marcorispoli/PCB313/Modelli/Scheda3D/M-RJE03-188-0X10-REVT1.STEP

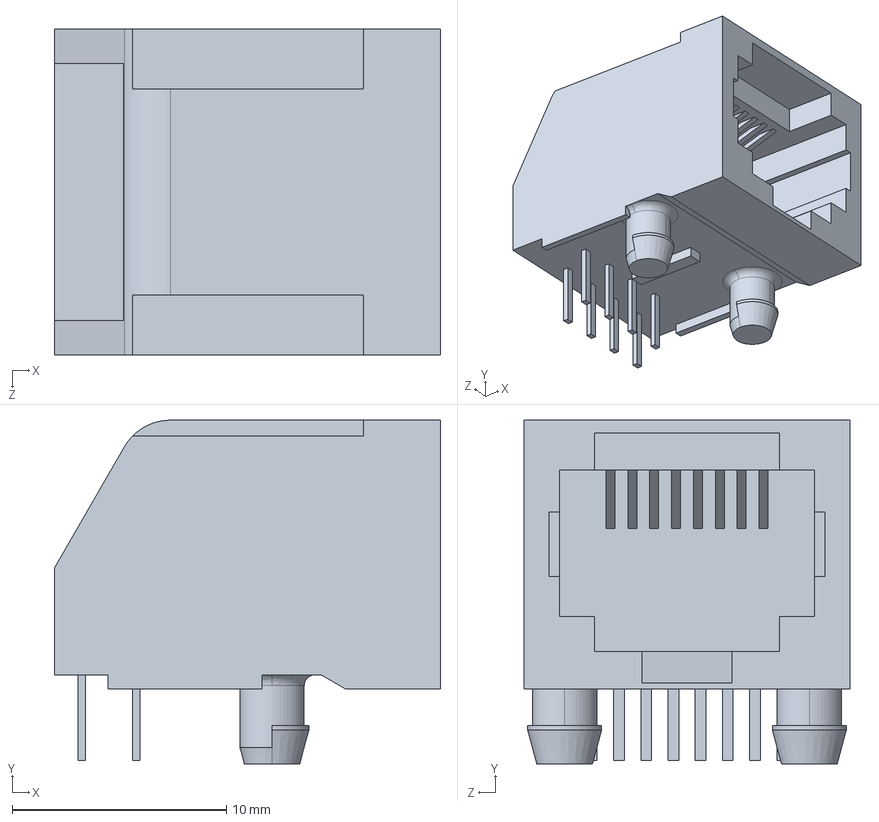
[picture p1: CAD file, 2023-08-30]
Modelli/Scheda3D/M-RJE03-188-0X10-REVT1.STEP
18.0 x 16.1 x 15.2 mm
