marcorispoli/PCB313/Modelli/Scheda3D/39-29-9043.stp

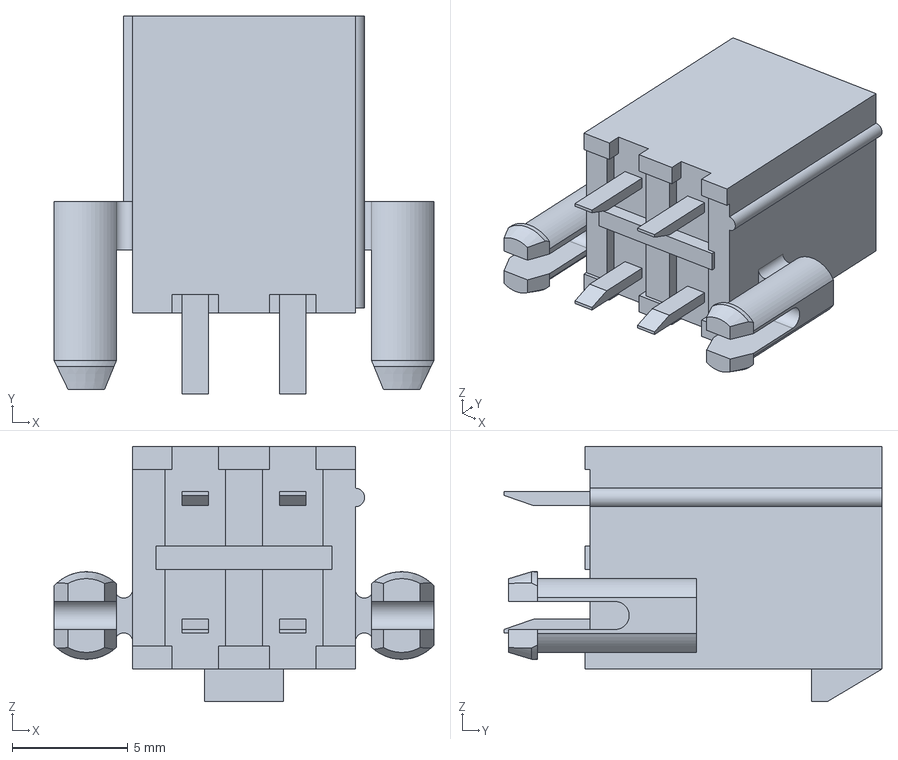
[picture p2: CAD file, 2023-08-30]
Modelli/Scheda3D/39-29-9043.stp
16.4 x 16.3 x 11.0 mm
