marcorispoli/PCB313/Modelli/Scheda3D/M-RJE08-188-0X10-REVT1.STEP

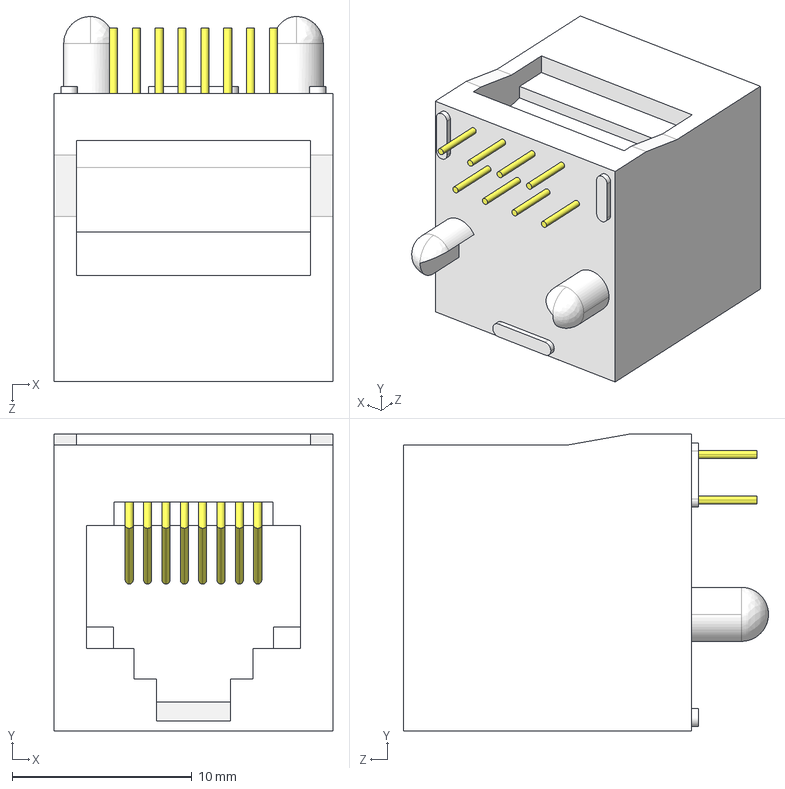
[picture p3: CAD file, 2023-08-30]
Modelli/Scheda3D/M-RJE08-188-0X10-REVT1.STEP
15.5 x 16.5 x 20.3 mm
