marcorispoli/PCB313/Modelli/Scheda3D/Scheda3D-Edge_Cuts.dxf

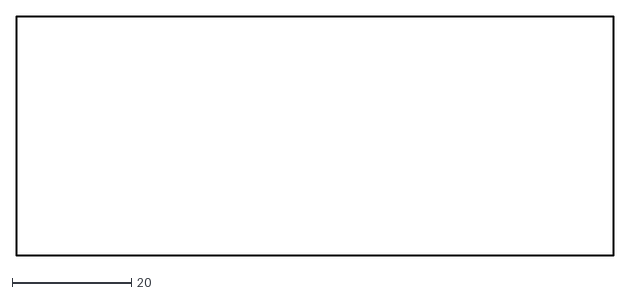
[picture p4: CAD file, 2023-08-30]
Modelli/Scheda3D/Scheda3D-Edge_Cuts.dxf
100.1 x 40.1
