marcorispoli/PCB313/Modelli/Scheda3D/SSM3K341R,LF.stp

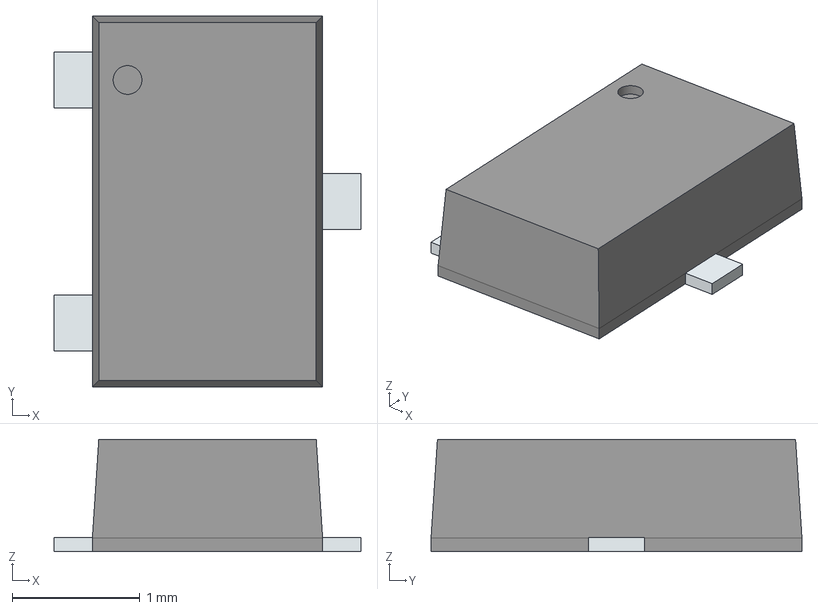
[picture p5: CAD file, 2023-08-30]
Modelli/Scheda3D/SSM3K341R,LF.stp
2.40 x 2.90 x 0.878 mm
PinsArrayL
PinsArrayR
