marcorispoli/PCB313/Modelli/Scheda3D/Scheda3D-F_Cu.dxf

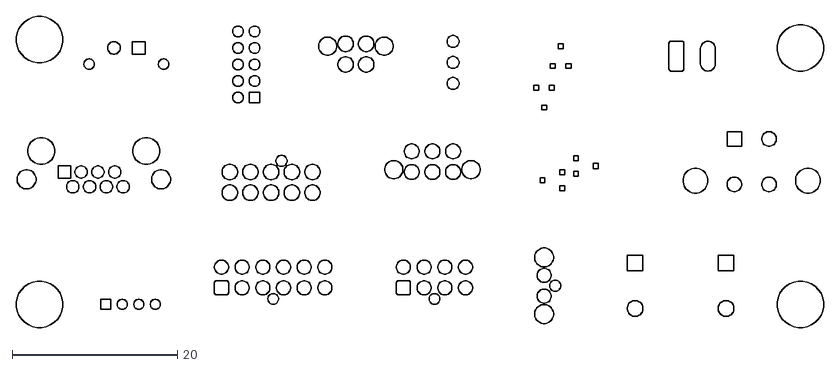
[picture p6: CAD file, 2023-08-30]
Modelli/Scheda3D/Scheda3D-F_Cu.dxf
97.6 x 37.6
