marcorispoli/PCB313/Modelli/Scheda3D/TSR_0.5-2450.stp

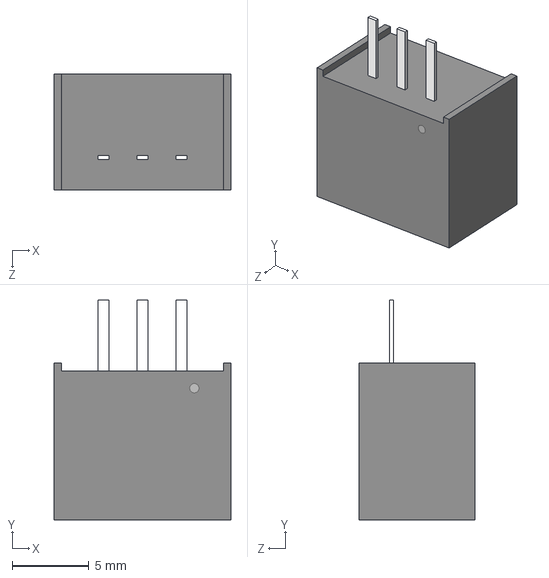
[picture p7: CAD file, 2023-08-30]
Modelli/Scheda3D/TSR_0.5-2450.stp
11.5 x 14.3 x 7.55 mm
