marcorispoli/PCB313/Modelli/Scheda3D/Scheda3D-B_Cu.dxf

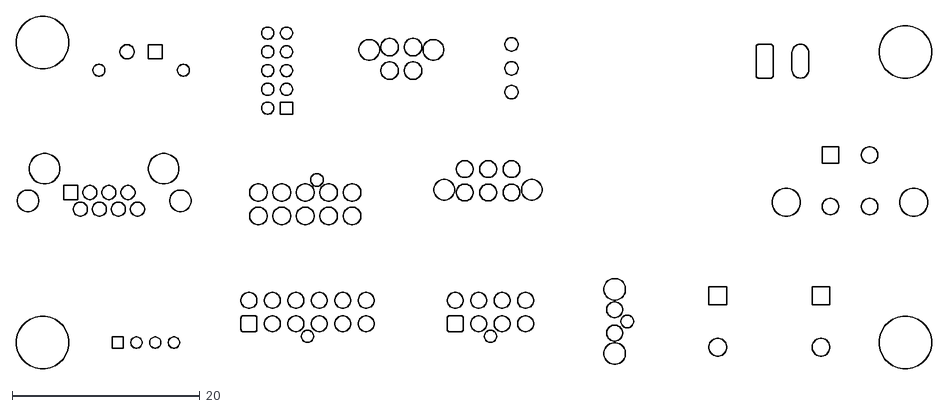
[picture p8: CAD file, 2023-08-30]
Modelli/Scheda3D/Scheda3D-B_Cu.dxf
97.6 x 37.6
