marcorispoli/PCB313/Modelli/Scheda3D/105311-1102.stp

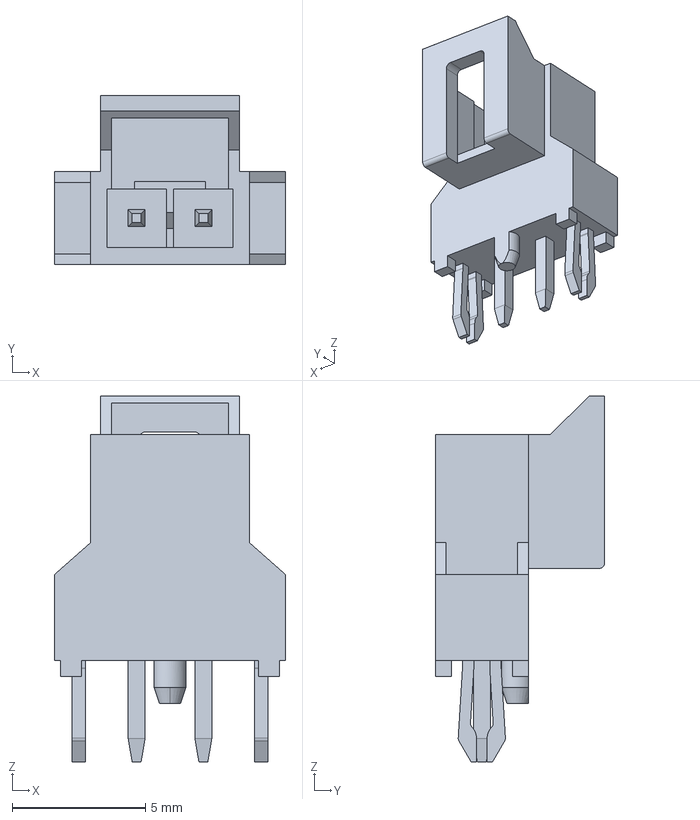
[picture p9: CAD file, 2023-08-30]
Modelli/Scheda3D/105311-1102.stp
8.66 x 6.34 x 13.7 mm
