marcorispoli/PCB313/Modelli/Scheda3D/105310-2212.stp

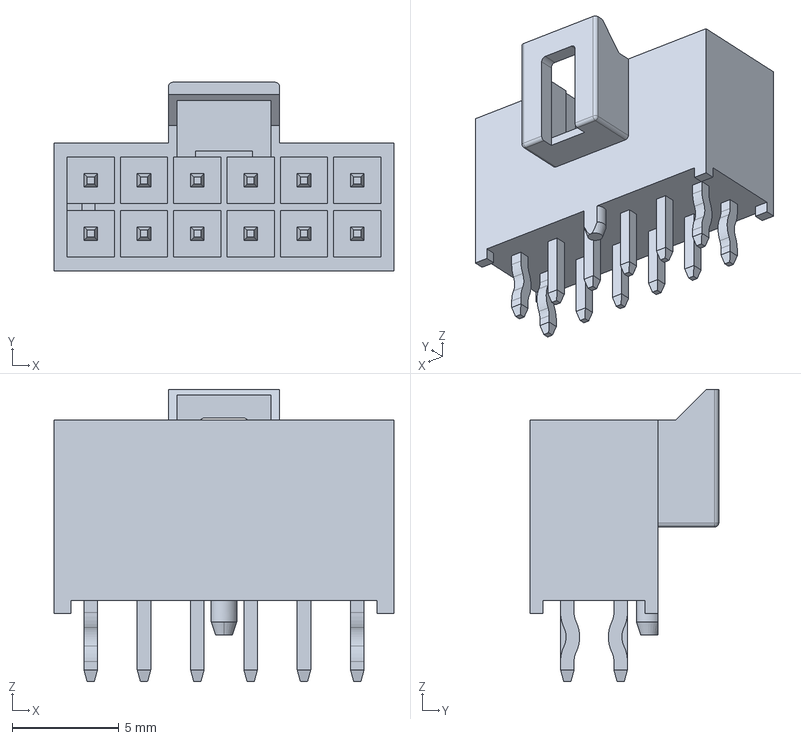
[picture p10: CAD file, 2023-08-30]
Modelli/Scheda3D/105310-2212.stp
15.9 x 8.84 x 13.7 mm
