marcorispoli/PCB313/Modelli/Scheda3D/105312-1106.stp

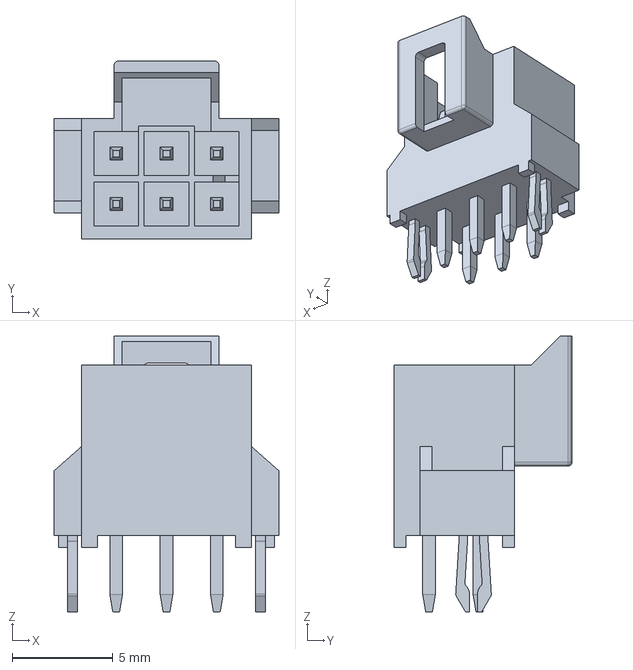
[picture p11: CAD file, 2023-08-30]
Modelli/Scheda3D/105312-1106.stp
11.2 x 8.84 x 13.7 mm
