marcorispoli/PCB313/Modelli/Scheda3D/105310-2210.stp

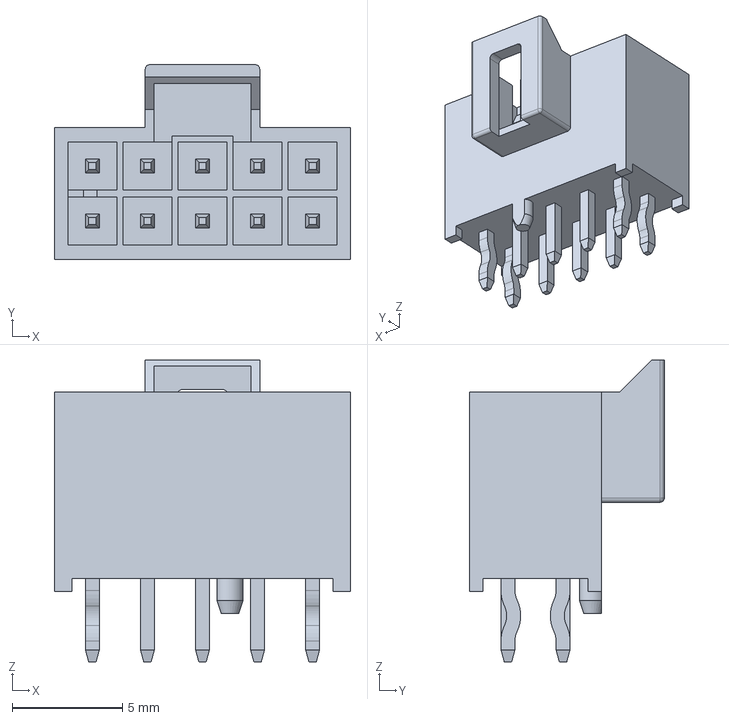
[picture p12: CAD file, 2023-08-30]
Modelli/Scheda3D/105310-2210.stp
13.4 x 8.84 x 13.7 mm
