marcorispoli/PCB313/Modelli/Scheda3D/105310-2108.stp

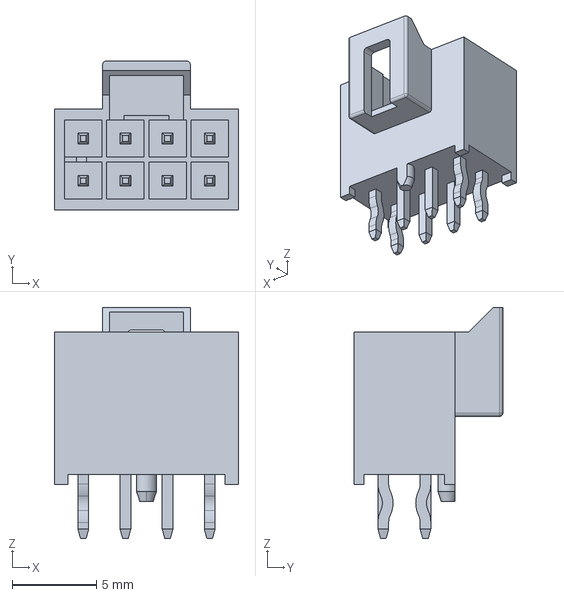
[picture p13: CAD file, 2023-08-30]
Modelli/Scheda3D/105310-2108.stp
10.9 x 8.84 x 13.7 mm
