marcorispoli/PCB313/Modelli/Scheda3D/105312-1104.stp

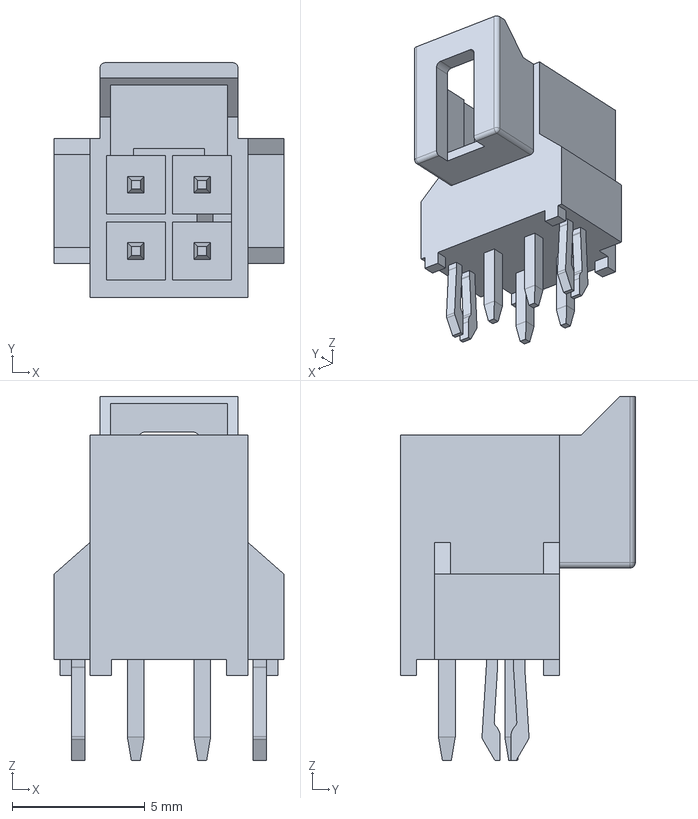
[picture p14: CAD file, 2023-08-30]
Modelli/Scheda3D/105312-1104.stp
8.66 x 8.84 x 13.7 mm
