marcorispoli/PCB313/Modelli/Scheda3D/43650-0215.stp

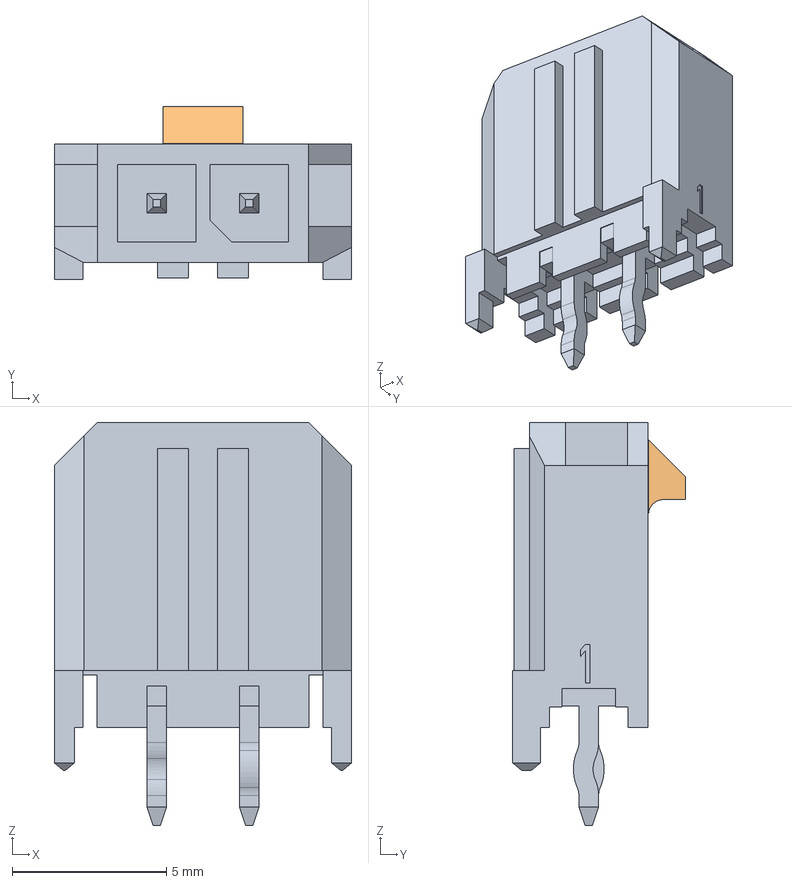
[picture p15: CAD file, 2023-08-30]
Modelli/Scheda3D/43650-0215.stp
9.65 x 5.61 x 13.1 mm
