marcorispoli/PCB313/(list of files, cad)

Other CAD files:
ESECUTIVI/PF22-313-0.dwg
LAYOUT/22-313-0.dwg
ESECUTIVI/PM22-313-0.dwg
Modelli/Scheda3D/292161-4.stp
Modelli/Scheda3D/46999-0138.stp
Modelli/Scheda3D/98414-G06-10LF.stp
Modelli/Scheda3D/Scheda3D-B_SilkS.dxf
Modelli/Scheda3D/Scheda3D-F_SilkS.dxf
