marcorispoli/PCB313/ORCAD/SE22-313-0.pdf

## PHOTOCELLS

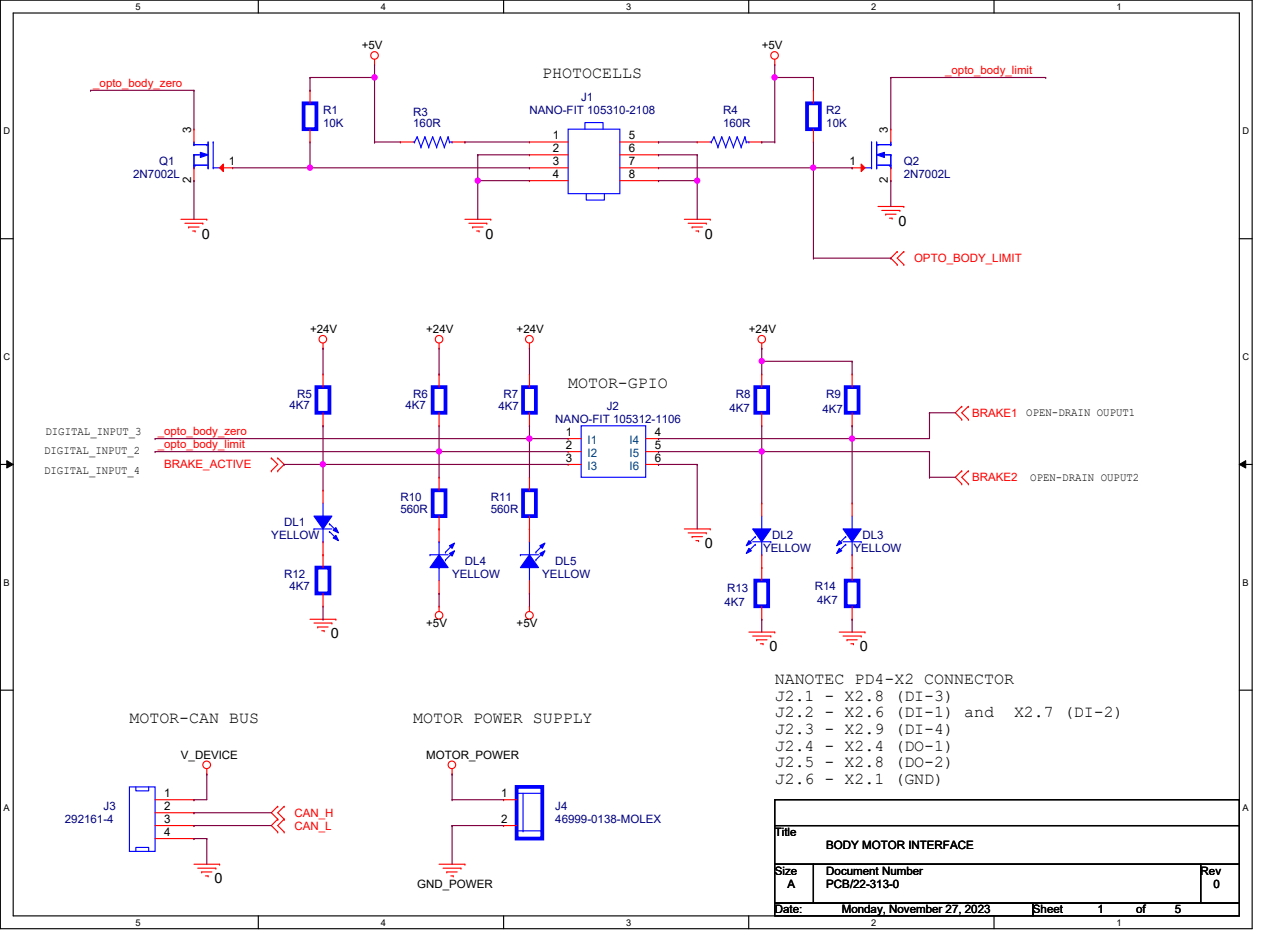
[picture p16: page 1]

## OUT TO BRAKE

BRAKE2 | | | BRAKE1 | | FRENO |

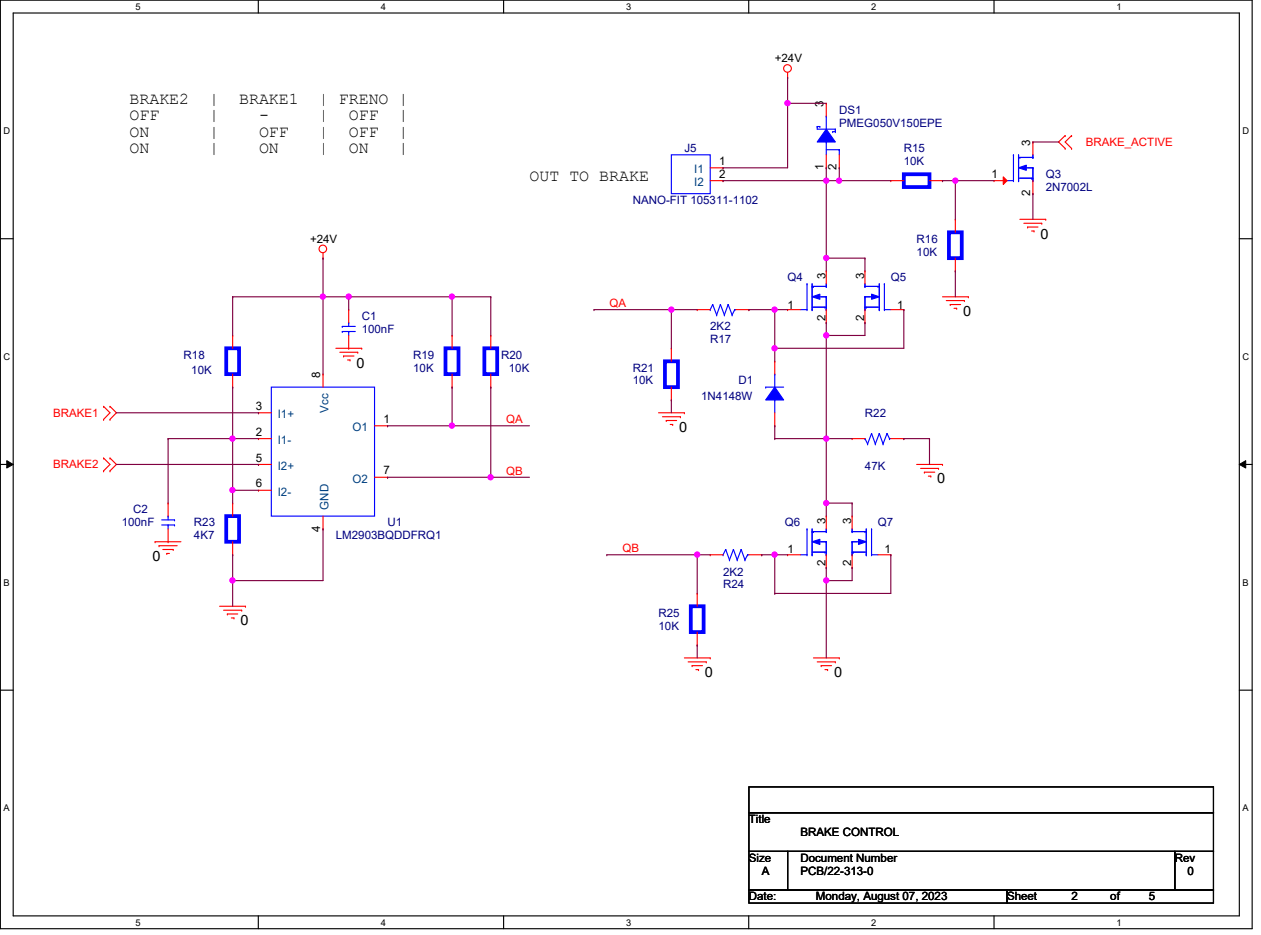
[picture p17: page 2]

## 24VDC@ 5A POWER-IN

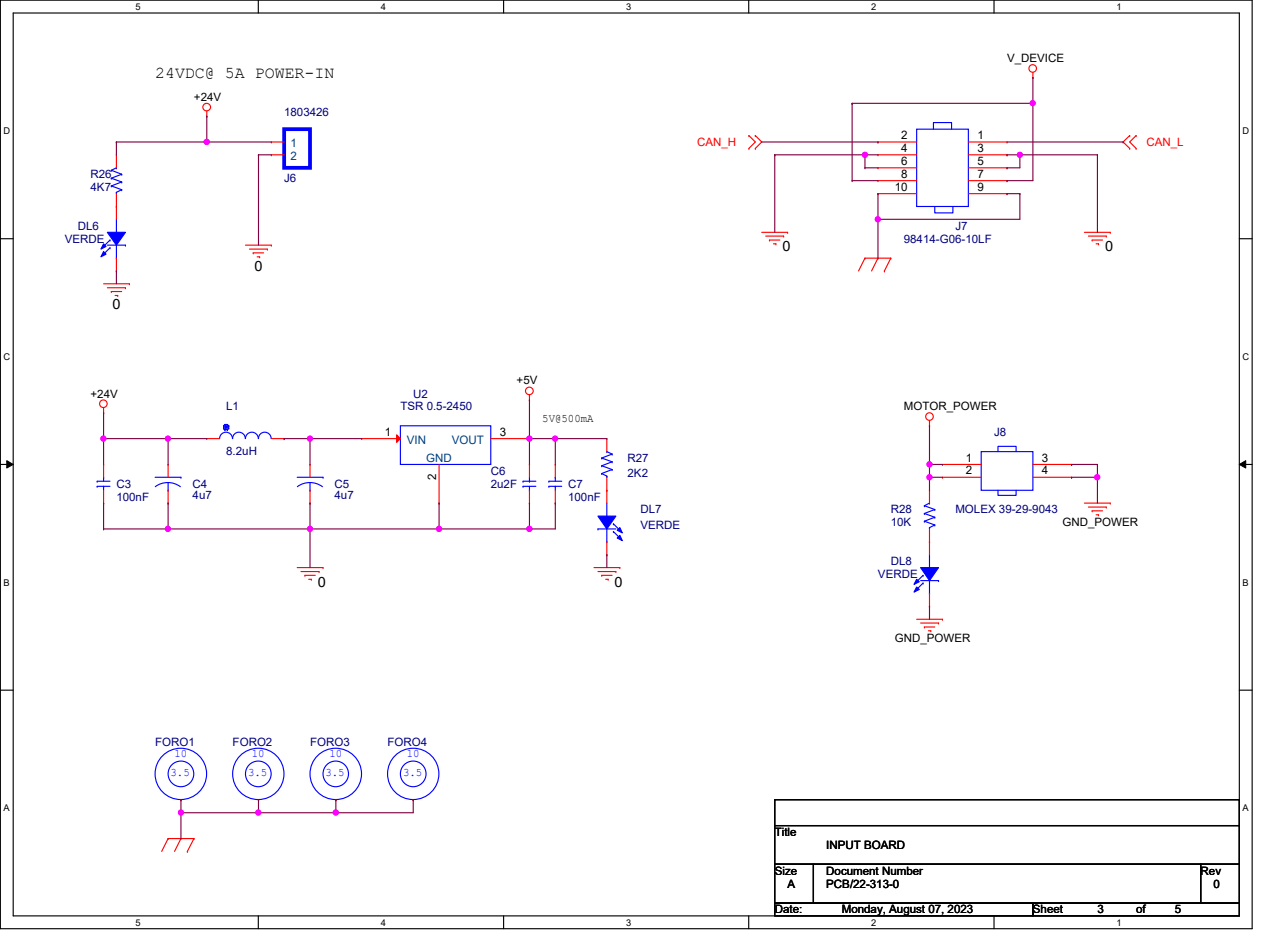
[picture p18: page 3]

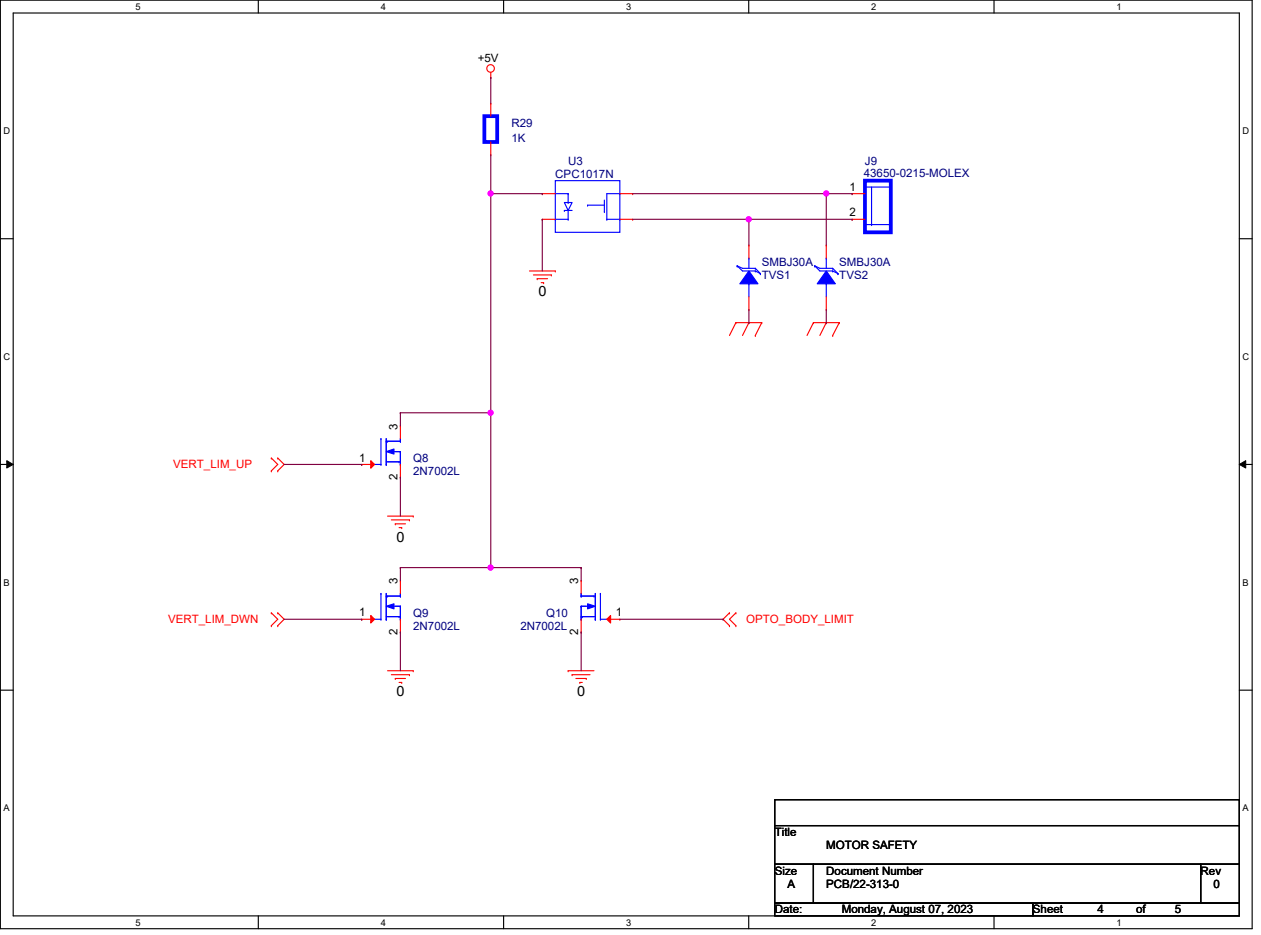
[picture p19: page 4]
VERT_LIM_UP; VERT_LIM_DWN; OPTO_BODY_LIMIT; Title; MOTOR SAFETY; 4 5Monday, August 07, 2023; J9 43650-0215-MOLEX; TVS1; SMBJ30A; U3 CPC1017N; TVS2

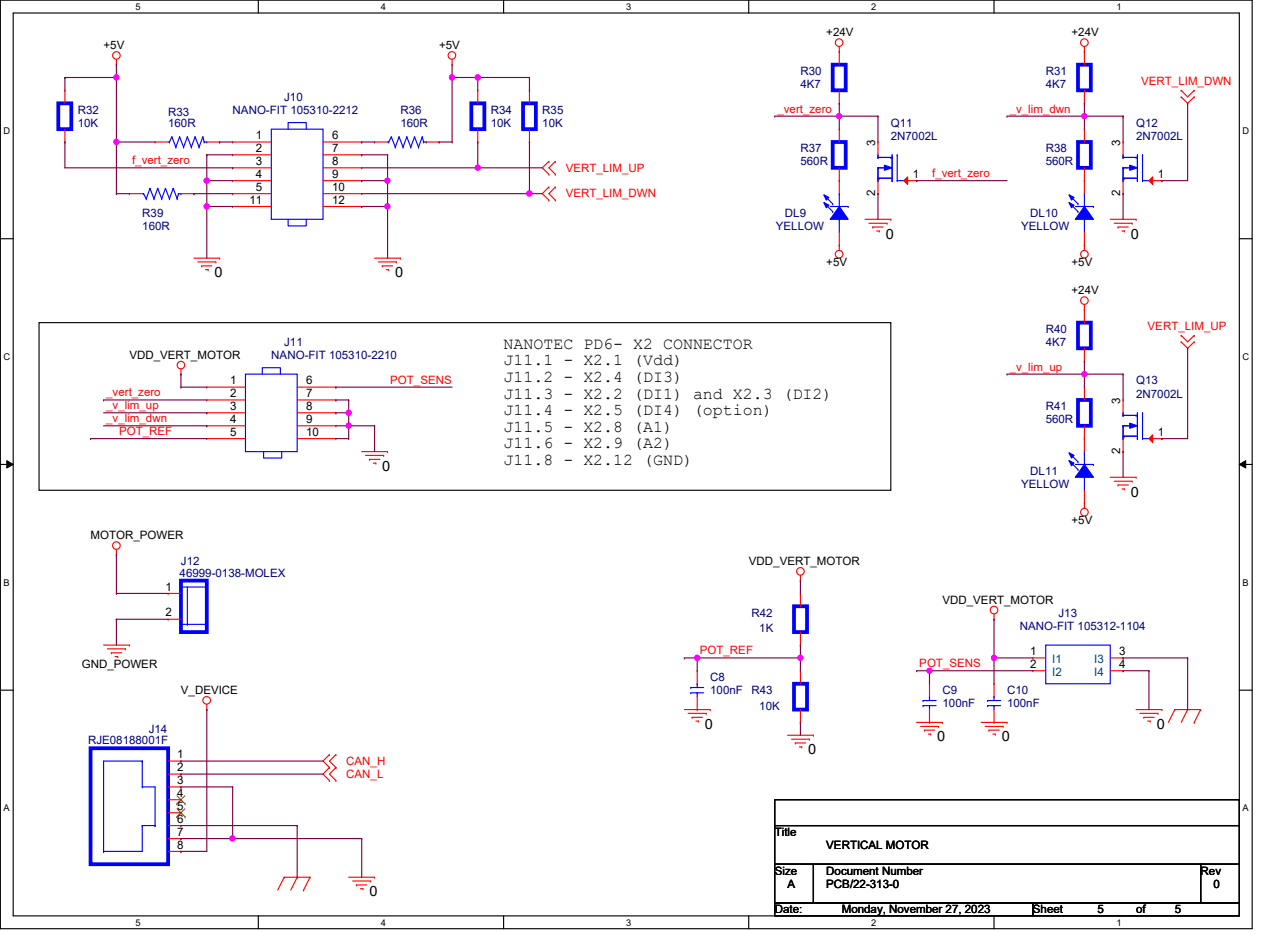
[picture p20: page 5]
