marcorispoli/PCB313/Modelli/Scheda3D/22-313-0.pdf

## PHOTOCELLS

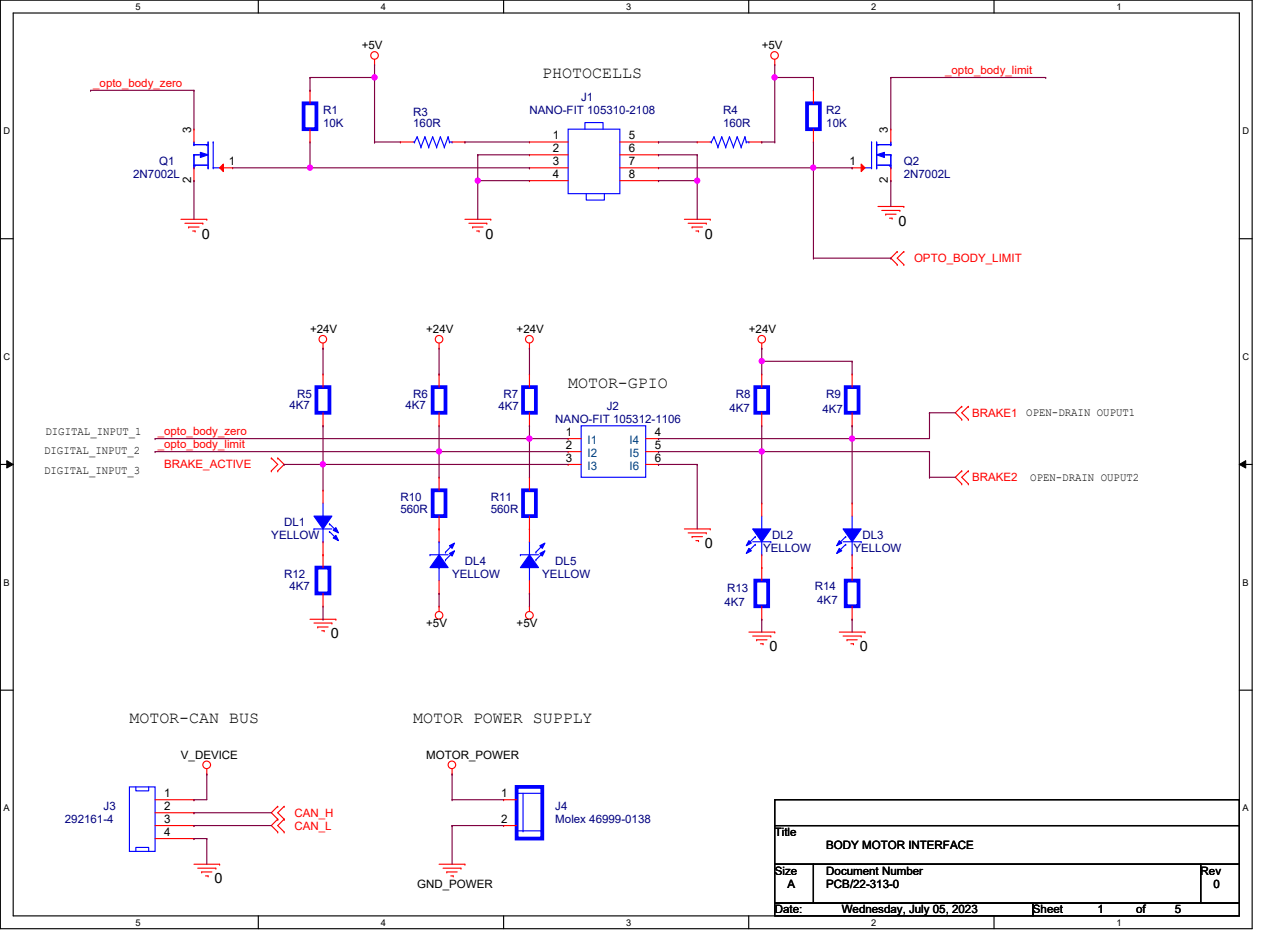
[picture p21: page 1]

## OUT TO BRAKE

BRAKE2 | | | BRAKE1 | | FRENO |

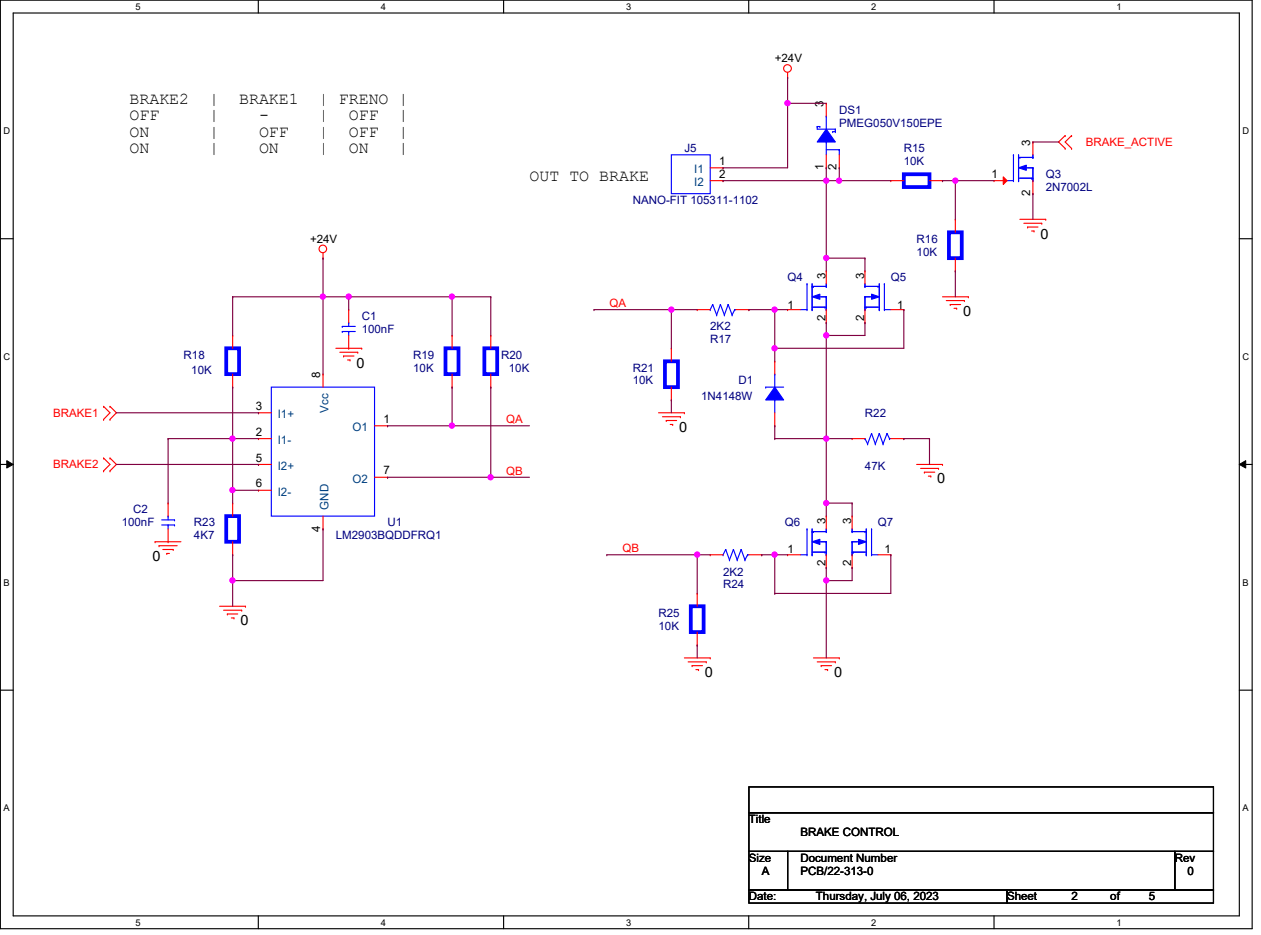
[picture p22: page 2]

## 24VDC@ 5A POWER-IN

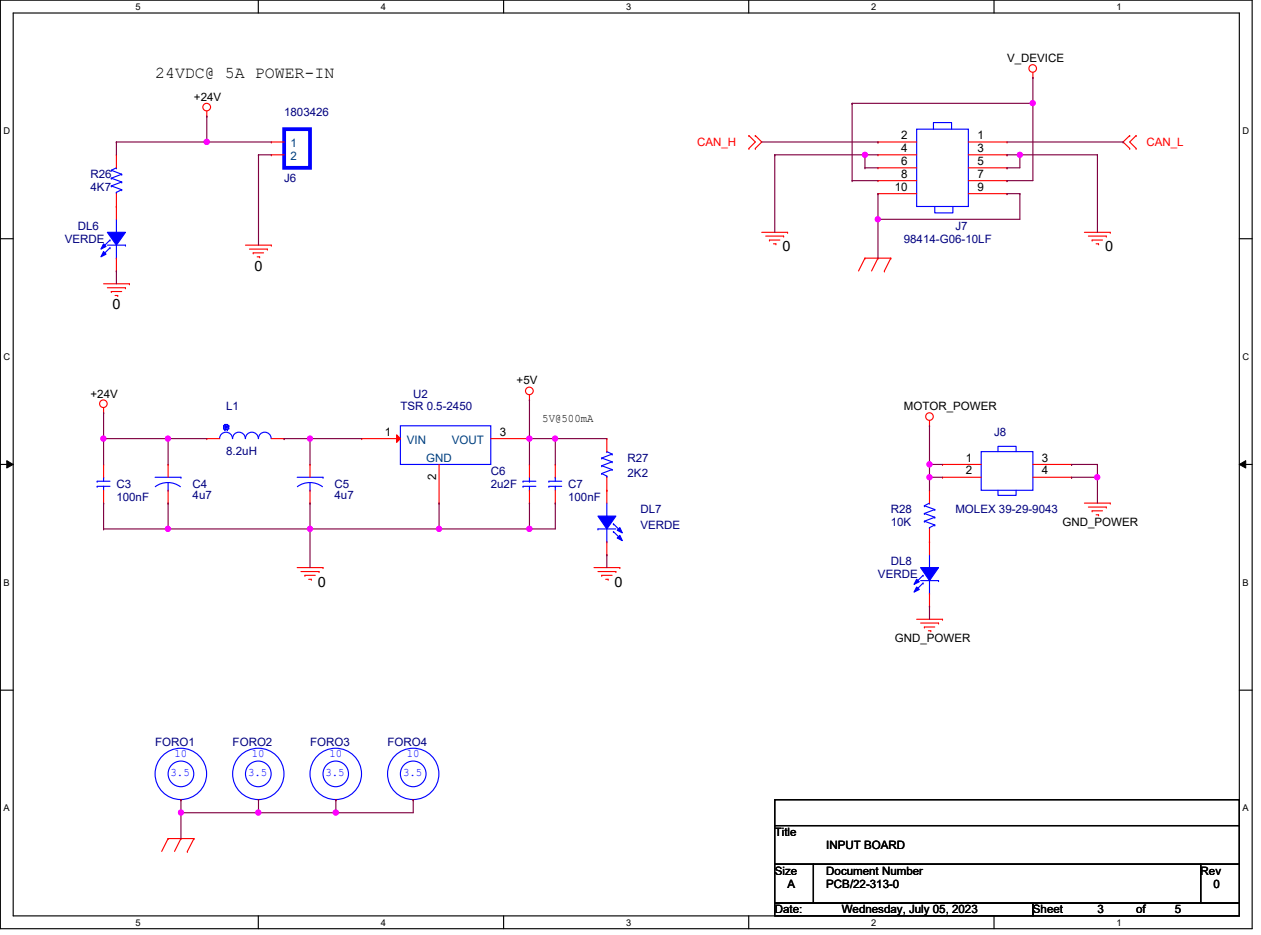
[picture p23: page 3]

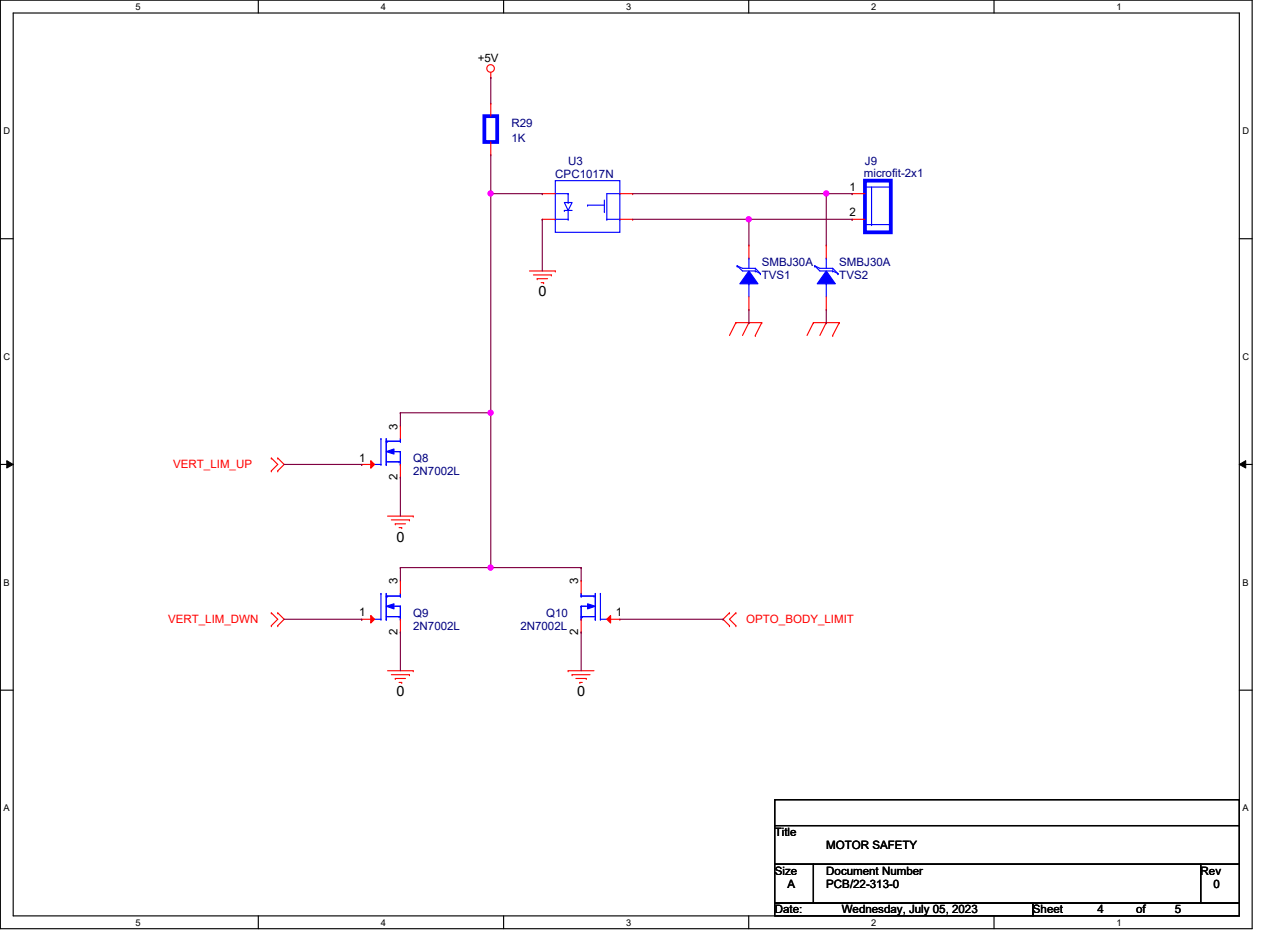
[picture p24: page 4]
VERT_LIM_UP; VERT_LIM_DWN; OPTO_BODY_LIMIT; Title; MOTOR SAFETY; 4 5Wednesday, July 05, 2023; J9 microfit-2x1; U3 CPC1017N; TVS2; SMBJ30A; TVS1

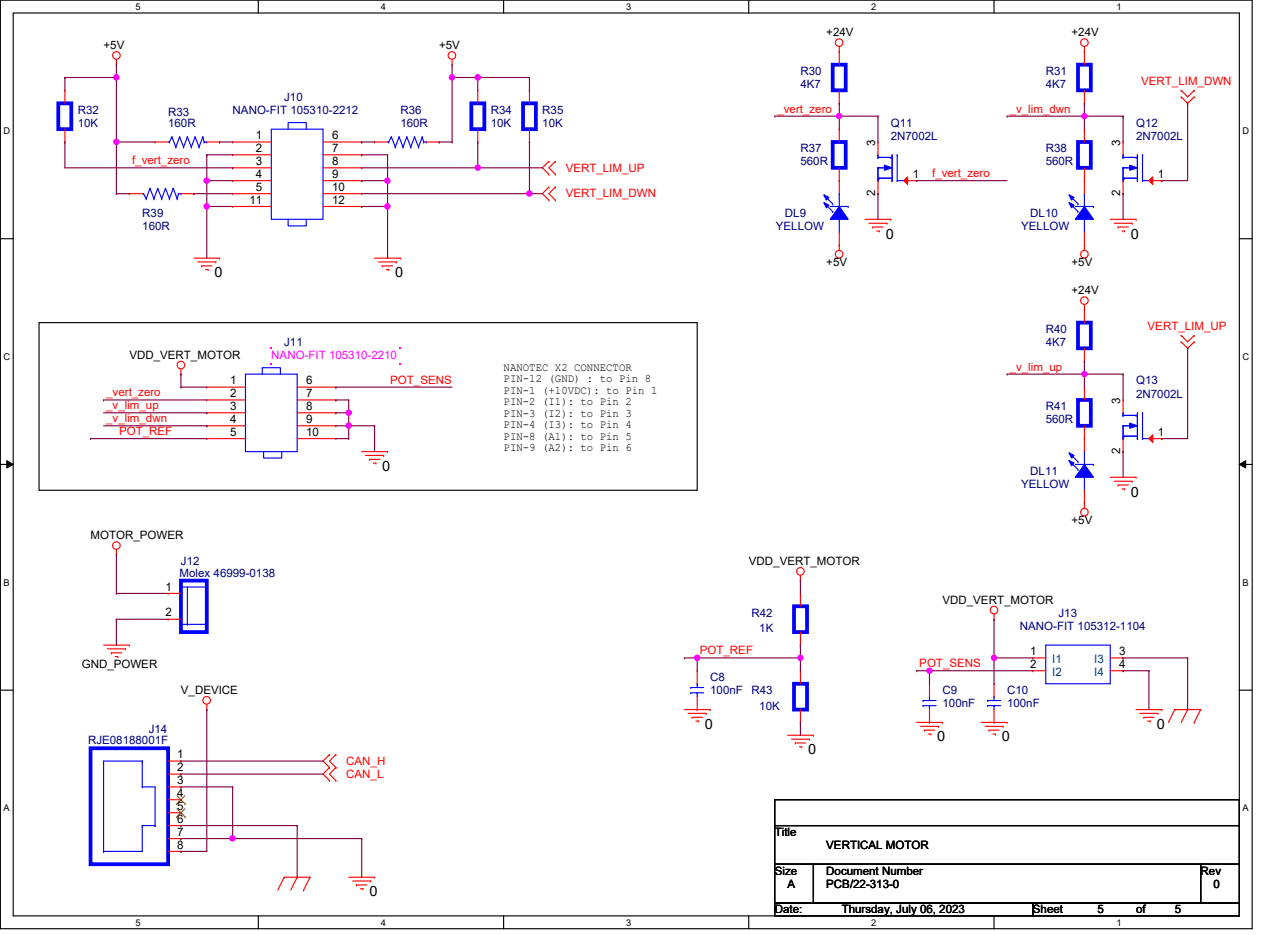
[picture p25: page 5]

NANOTEC X2 CONNECTOR
PIN-12 (GND) : to Pin 8
PIN-1 (+10VDC): to Pin 1
PIN-2 (I1): to Pin 2
PIN-3 (I2): to Pin 3
PIN-4 (I3): to Pin 4
PIN-8 (A1): to Pin 5
PIN-9 (A2): to Pin 6
