marcorispoli/PCB313/ESECUTIVI/PF22-313-0 .pdf

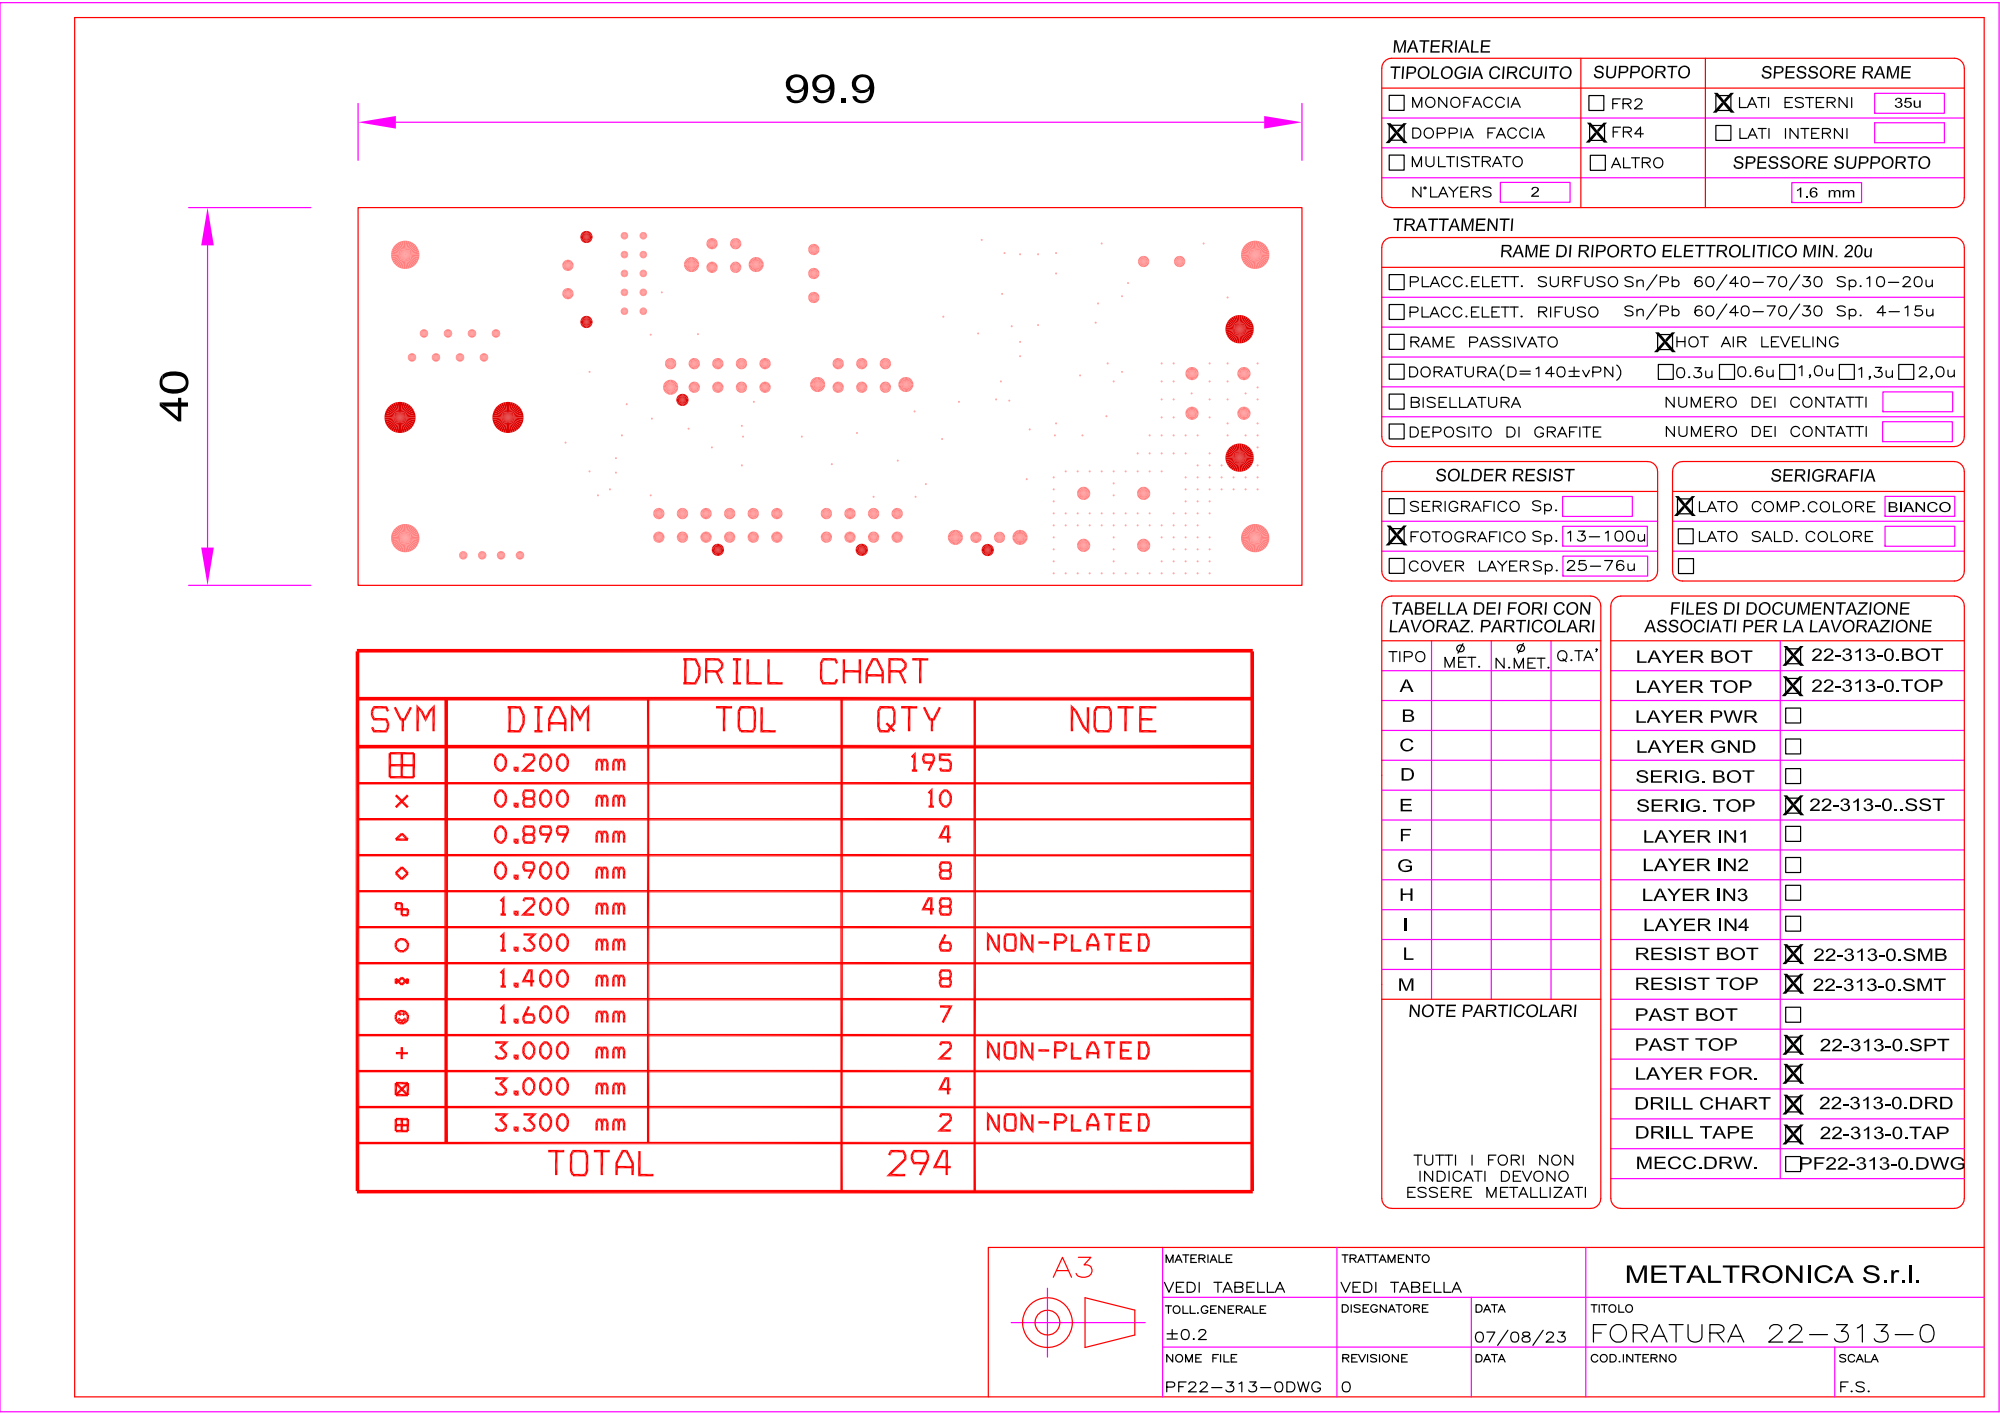
[picture p26: page 1]
