marcorispoli/PCB313/ESECUTIVI/PM22-313-0.pdf

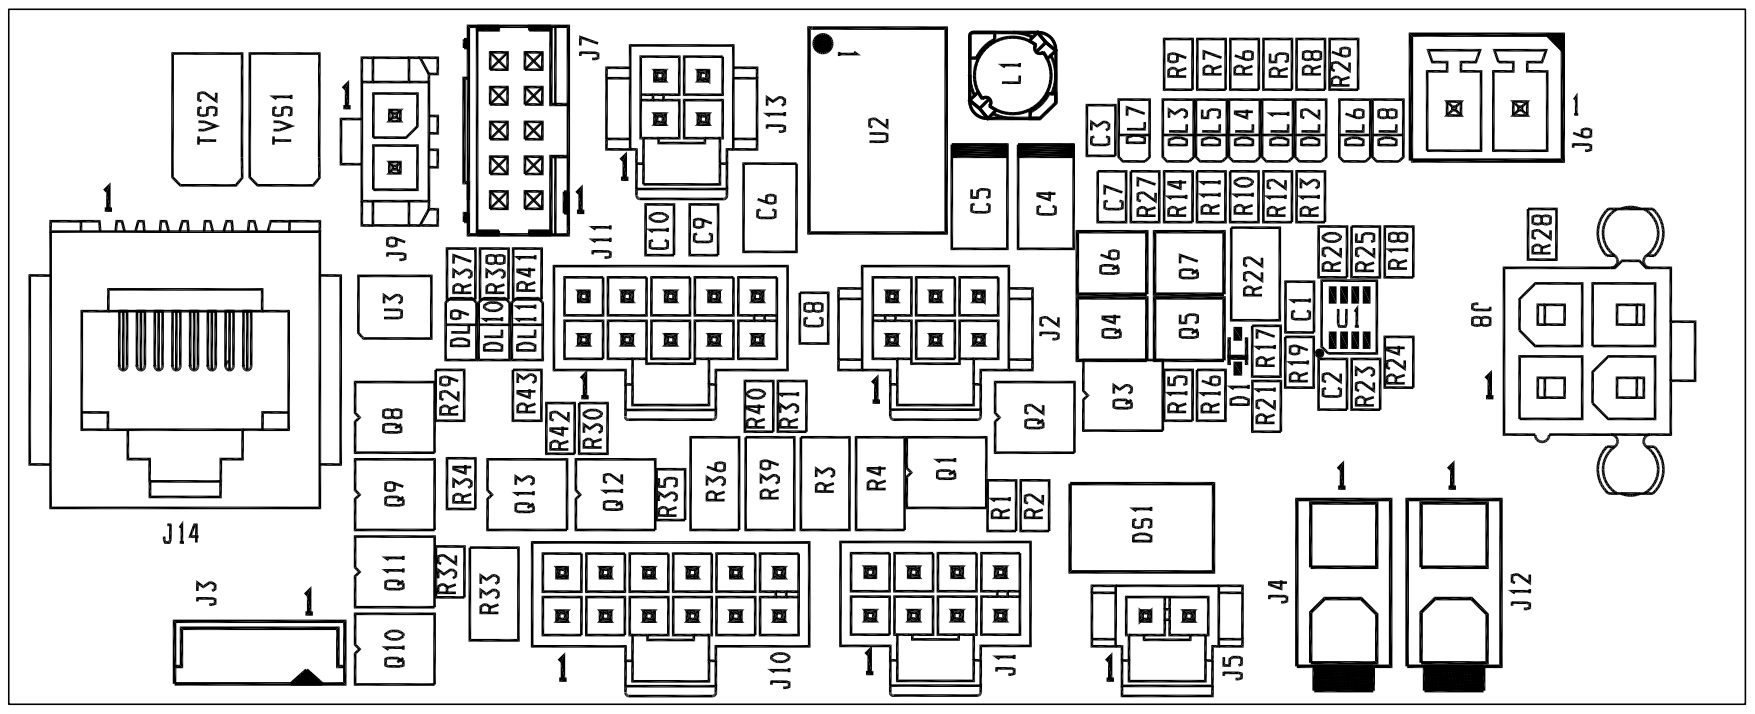
[picture p27: page 1]
