marcorispoli/PCB313/(list of files, drawings)

Other design files:
ORCAD/22-313-0.DSN
ORCAD/22-313-0.opj
