marcorispoli/PCB313/Modelli/Scheda3D/Scheda3D.sch

## KiCad design Modelli/Scheda3D/Scheda3D.sch (2023-08-30)

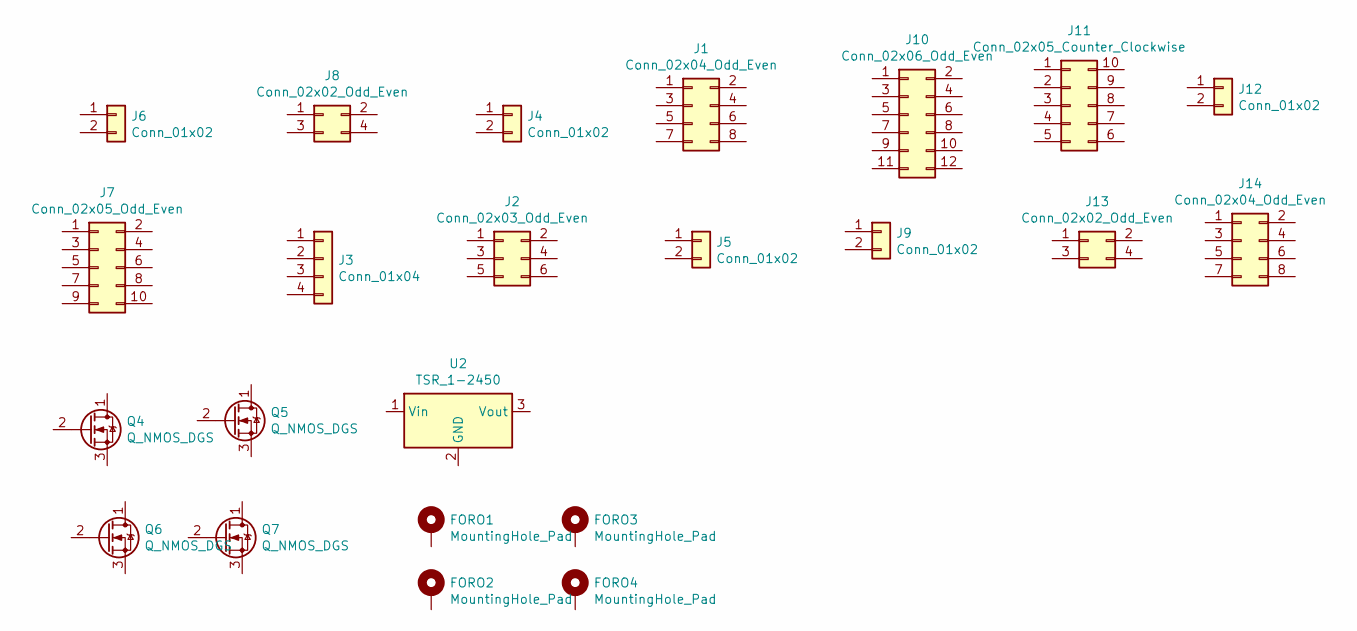
[picture p28: schematic Scheda3D.sch]

Parts:
FORO1, FORO2, FORO3, FORO4: MountingHole_Pad; MountingHole_3.2mm_M3_DIN965_Pad_TopBottom
J1: Conn_02x04_Odd_Even; Molex_Nano-Fit_105310-xx08_2x04_P2.50mm_Vertical
J2: Conn_02x03_Odd_Even; 1053121106
J3: Conn_01x04; SHDR4W60P0X200_1X4_980X360X680P
J4, J12: Conn_01x02; 46999-0138
J5: Conn_01x02; 1053111102
J6: Conn_01x02; PhoenixContact_MCV_1,5_2-G-3.81_1x02_P3.81mm_Vertical
J7: Conn_02x05_Odd_Even; 98414G0610LF
J8: Conn_02x02_Odd_Even; 39-29-904Y
J9: Conn_01x02; 43650-02YY_151617
J10: Conn_02x06_Odd_Even; Molex_Nano-Fit_105310-xx12_2x06_P2.50mm_Vertical
J11: Conn_02x05_Counter_Clockwise; 1053102210
J13: Conn_02x02_Odd_Even; 1053121104
J14: Conn_02x04_Odd_Even; RJ45_Amphenol_RJHSE5380
Q4, Q5, Q6, Q7: Q_NMOS_DGS; SOTFL95P240X88-3N
U2: TSR_1-2450; TSR-0.5-2433
