marcorispoli/PCB313/(commit log)

2023-05-05 Creazione progetto
    [22-313-0.DSN, 22-313-0.opj]
2023-05-18 Progetto di massima completato
    [22-313-0.DSN, 22-313-0.opj]
2023-08-30 MAsterizzata per prima prototipazione
    [105310-2108.stp, 105310-2210.stp, 105310-2212.stp, 105311-1102.stp, 105312-1104.stp, 105312-1106.stp, 22-313-0.DSN, 22-313-0.dwg]
2023-11-27 Modificato assegnamento pin GPIO motori (no modifiche a PCB, solo schematico)
    [22-313-0.DSN, 22-313-0.opj]
2024-01-09 Corretto BUG sul cartiglio GPIO Body Motor
    [22-313-0.DSN, 22-313-0.opj, Scheda3D-B_Cu.dxf, Scheda3D-B_SilkS.dxf, Scheda3D-Edge_Cuts.dxf, Scheda3D-F_Cu.dxf, Scheda3D-F_SilkS.dxf]
